j21marshall/amblyopia-tracker/README.md

# amblyopia-tracker
An electrical engineering senior design project, made with James Liu and Sean McCarthy, to accompany an eye-tracking headset
