j21marshall/amblyopia-tracker/(commit log)

2020-05-12 Placeholder file for arduino folder
2020-05-12 Arduino files
